m1dst/RaynetTrailerPowerManagement/PCB/Shield.brd

## EAGLE design PCB/Shield.brd (2019-07-08)

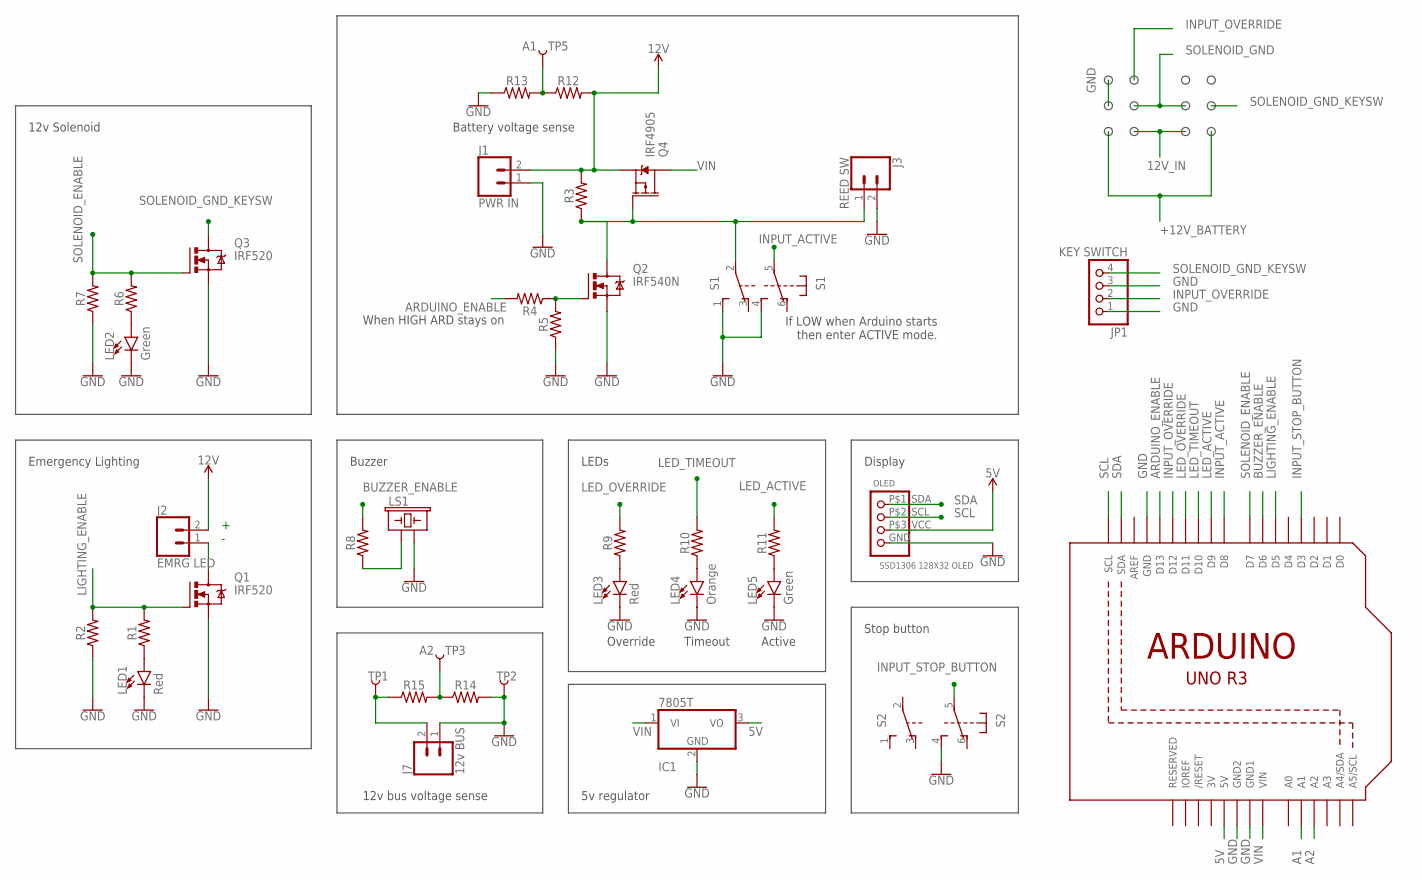
[picture p1: schematic Shield.sch]

Parts:
IC1: 7805T; TO220H
J1: PWR IN; SCREWTERMINAL-5MM-2
J2: EMRG LED; SCREWTERMINAL-5MM-2
J3: REED SW; SCREWTERMINAL-5MM-2
J7: 12v BUS; SCREWTERMINAL-5MM-2
JP1: KEY SWITCH; 1X04
LED1, LED3: Red; LED_3MM
LED2, LED5: Green; LED_3MM
LED4: Orange; LED_3MM
LS1: BUZZER; BUZZER-12MM-KIT
OLED: SSD1306 128X32 OLED; SSD1306_128X32_OLED
Q1, Q3: IRF520; TO220BV
Q2: IRF540N; TO220BV
Q4: IRF4905; TO220V
R1, R2, R6, R7: 1k; AXIAL-0.3
R3, R13, R14: 100k; AXIAL-0.3
R4, R8: 100; AXIAL-0.3
R5: 10k; AXIAL-0.3
R9, R10, R11: 330; AXIAL-0.3
R12, R15: 1m; AXIAL-0.3
S1, S2: 8X8_PCB_PUSH_BUTTON_DPDT
TP1, TP2, TP3, TP5: TEST-POINT3X5; PAD.03X.05
U1: ARDUINOR3-DIMENSION; ARDUINOR3

Connections:
3V: U1.3V
5V: IC1.3 (VO), OLED.P$3_VCC (VCC), U1.5V
12V_IN: J1.2, J2.2, Q4.3 (S), R3.P$2 (2), R12.P$2 (2)
A1: R12.P$1 (1), R13.P$2 (2), TP5.P$1, U1.A1
A2: R14.P$1 (1), R15.P$2 (2), TP3.P$1, U1.A2
ARDUINO_ENABLE: R4.P$2 (2), U1.D13
BUZZER_ENABLE: R8.P$2 (2), U1.D6
GND: IC1.2 (GND), J1.1, J3.2, J7.1, JP1.1, JP1.3, LED1.K (C), LED2.K (C), LED3.K (C), LED4.K (C), LED5.K (C), LS1.- (2), OLED.GND, Q1.S, Q2.S, Q3.S, R2.P$1 (1), R5.P$1 (1), R7.P$1 (1), R13.P$1 (1), R14.P$2 (2), S1.1 (S), S1.4 (S), S2.4 (S), TP2.P$1, U1.GND, U1.GND1, U1.GND2
INPUT_ACTIVE: S1.5, U1.D8
INPUT_OVERRIDE: JP1.2, U1.D12
INPUT_STOP_BUTTON: S2.5, U1.D3
LED_ACTIVE: R11.P$2 (2), U1.D9
LED_OVERRIDE: R9.P$2 (2), U1.D11
LED_TIMEOUT: R10.P$2 (2), U1.D10
LIGHTING_ENABLE: Q1.G, R1.P$2 (2), R2.P$2 (2), U1.D5
unnamed: J2.1, Q1.D
unnamed: LED1.A, R1.P$1 (1)
unnamed: J7.2, R15.P$1 (1), TP1.P$1
unnamed: J3.1, Q2.D, Q4.1 (G), R3.P$1 (1), S1.2
unnamed: Q2.G, R4.P$1 (1), R5.P$2 (2)
unnamed: LED2.A, R6.P$1 (1)
unnamed: LS1.+ (1), R8.P$1 (1)
unnamed: LED3.A, R9.P$1 (1)
unnamed: LED4.A, R10.P$1 (1)
unnamed: LED5.A, R11.P$1 (1)
SCL: OLED.P$2_SCL (SCL), U1.SCL
SDA: OLED.P$1_SDA (SDA), U1.SDA
SOLENOID_ENABLE: Q3.G, R6.P$2 (2), R7.P$2 (2), U1.D7
SOLENOID_GND_KEYSW: JP1.4, Q3.D
VIN: IC1.1 (VI), Q4.2 (D), U1.VIN

Notes on the sheet:
+ -
When HIGH ARD stays on
If LOW when Arduino starts then enter ACTIVE mode.
Emergency Lighting
12v Solenoid
Buzzer
Override
Timeout
Active
Battery voltage sense
12v bus voltage sense
LEDs
Display
Stop button
5v regulator

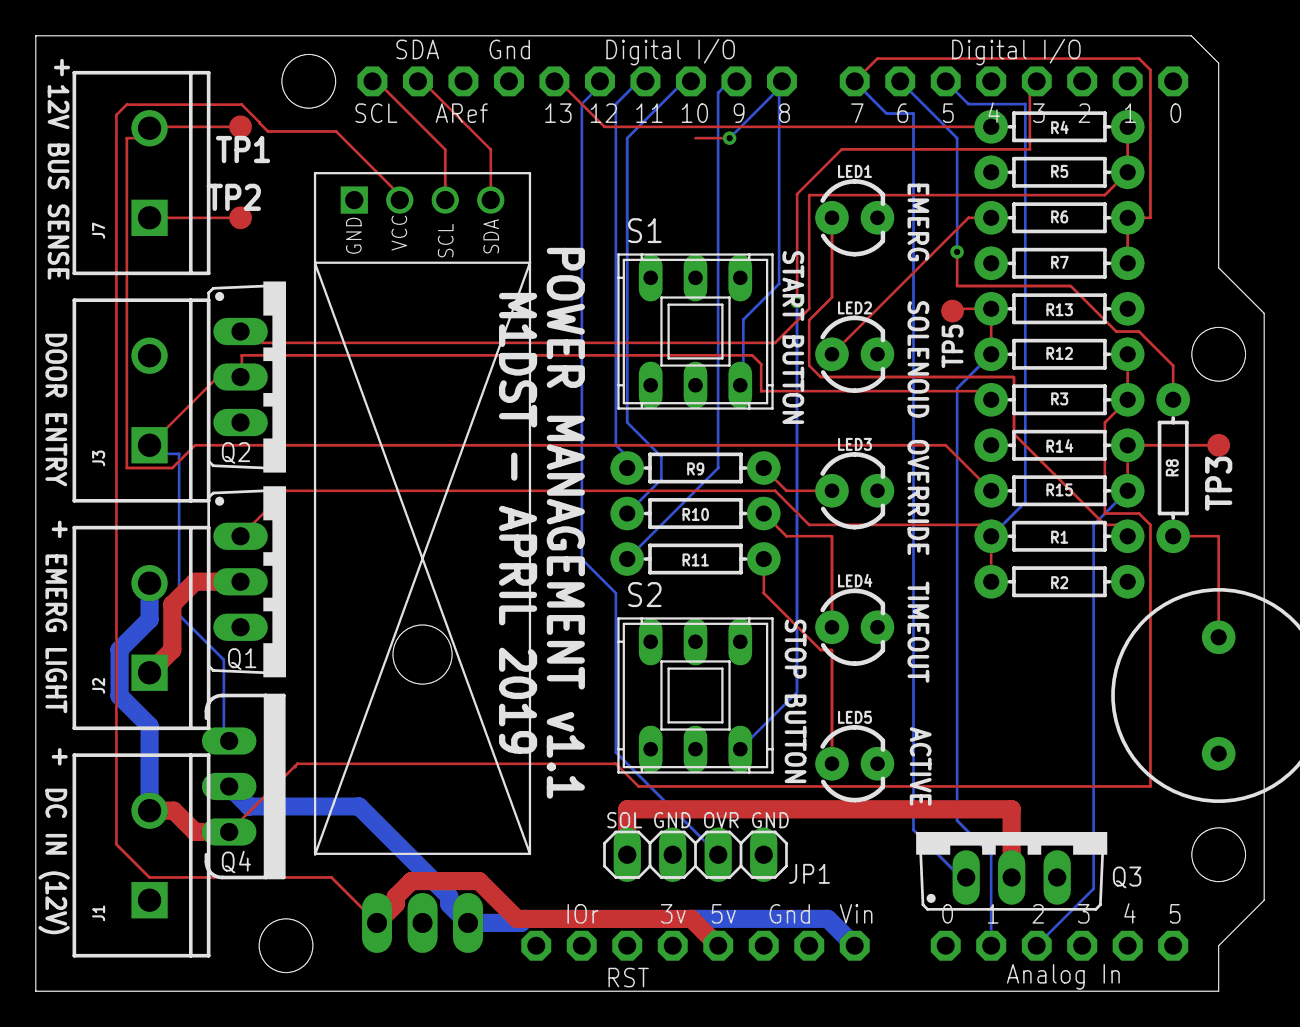
[picture p2: board Shield.brd from above]

Board: 2 copper layers, 68.6 x 53.3 mm, 39 parts (1 on the bottom side), 29 nets.
