m1dst/RaynetTrailerPowerManagement/(commit log)

2019-07-08 Version 1.0
    Core functionality - Requires cleanup and comments.
    [Shield.brd, Shield.sch]
2021-09-06 Allow the alarm to auto reset after 15 minutes.
    [PowerController.ino]
2021-09-06 Attempt to fix some screen corruption
    [PowerController.ino]
